decmike91/spectro/docs/images/android_4_traitement.png

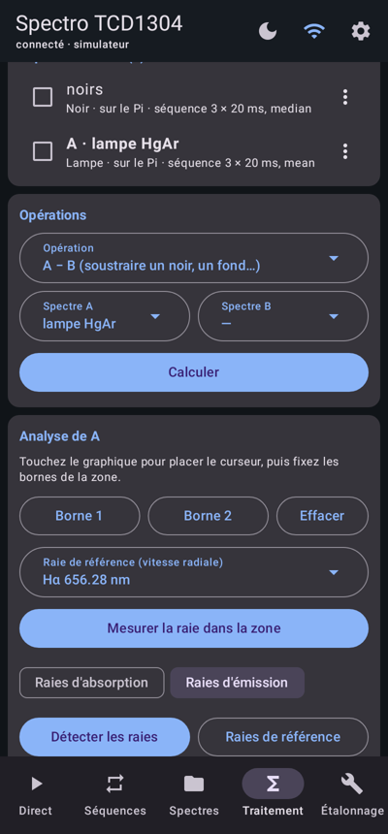
docs/images/android_4_traitement.png
