decmike91/spectro/docs/images/schema_electronique.png

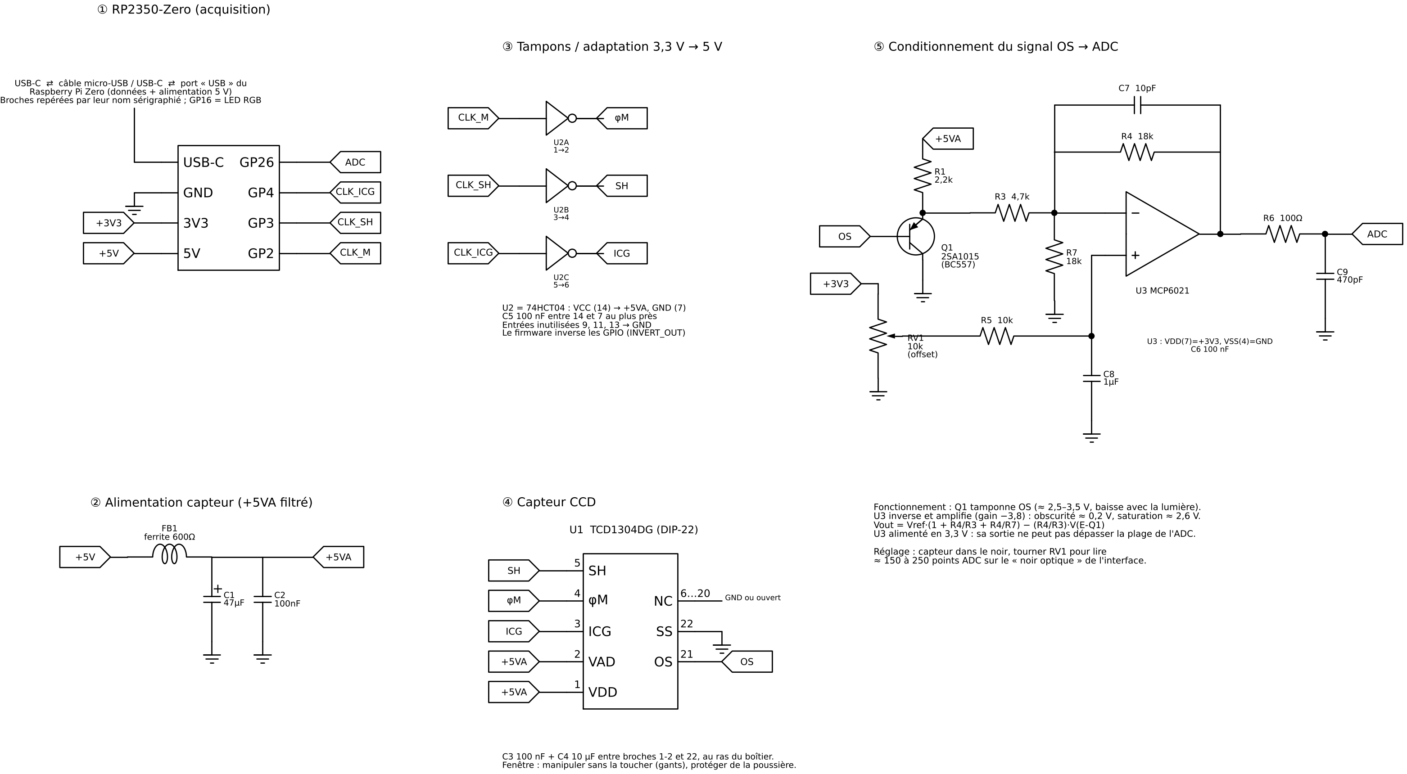
docs/images/schema_electronique.png
