decmike91/spectro/docs/images/v1_dessus.png

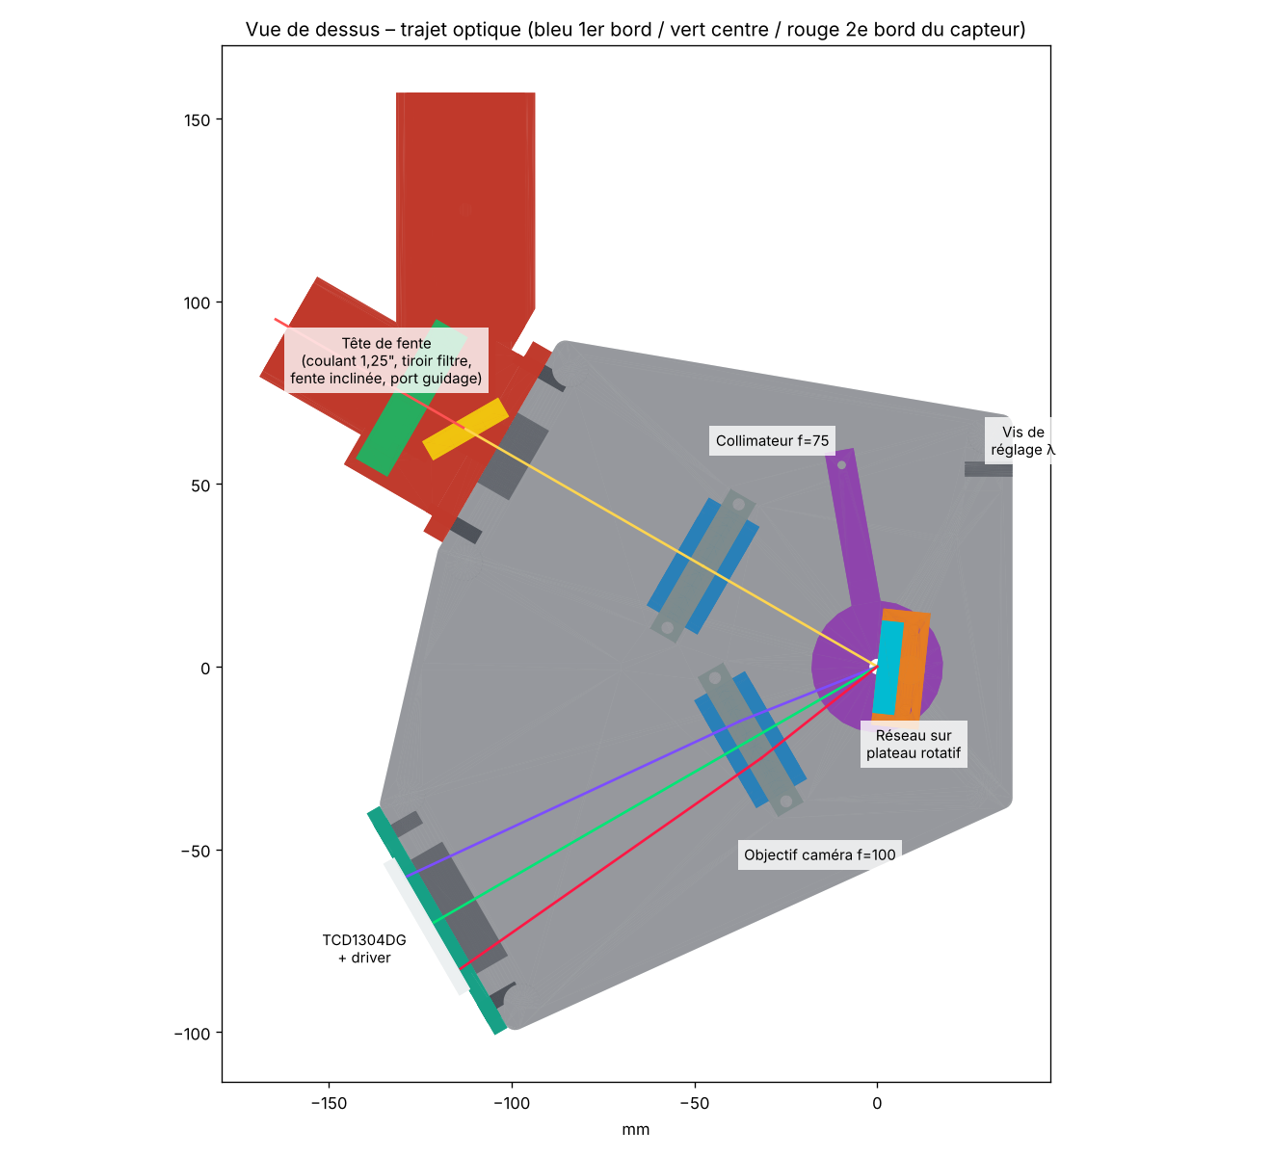
docs/images/v1_dessus.png
