decmike91/spectro/docs/images/v1_iso.png

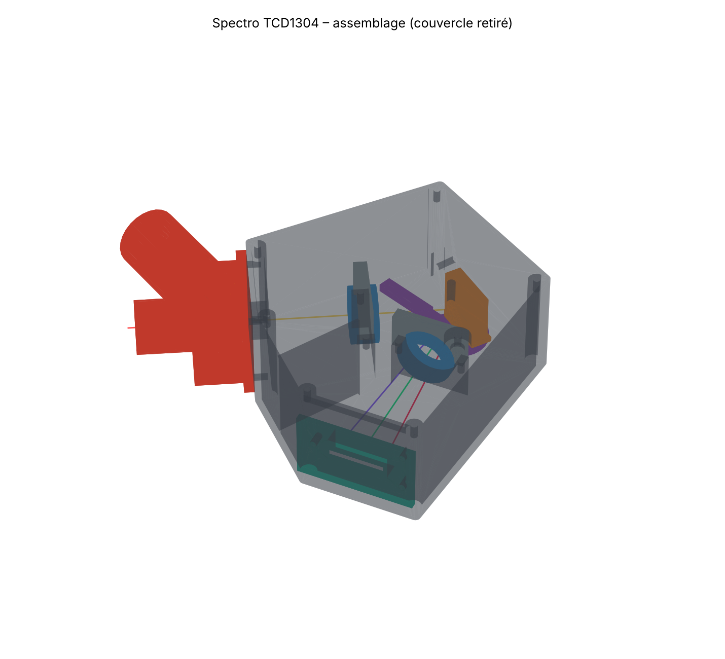
docs/images/v1_iso.png
