decmike91/spectro/docs/images/v2_iso.png

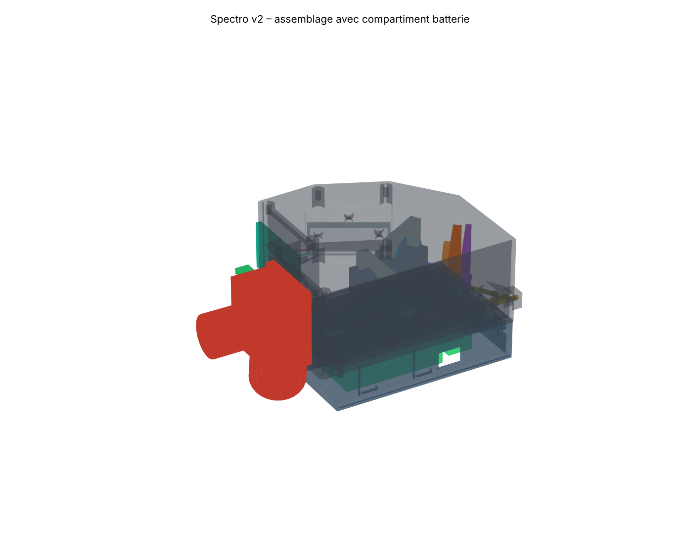
docs/images/v2_iso.png
