decmike91/spectro/docs/images/v2_monture_reseau.png

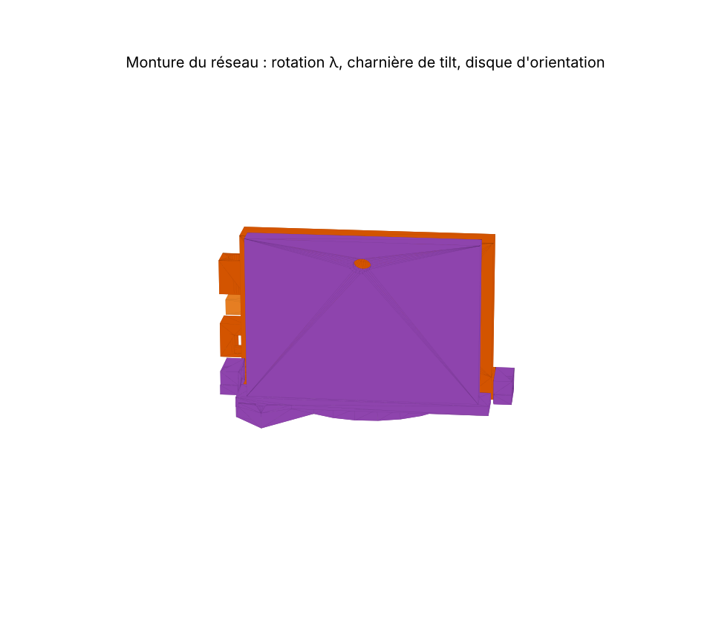
docs/images/v2_monture_reseau.png
