decmike91/spectro/mecanique/v2/export_v2/spectro_v2_assemblage.step

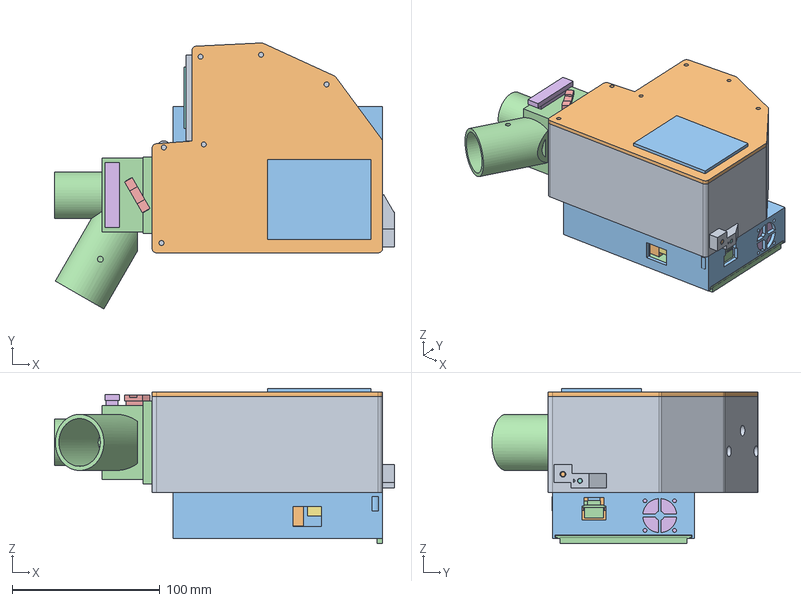
[picture p16: CAD file, 2026-11-10]
mecanique/v2/export_v2/spectro_v2_assemblage.step
230.0 x 180.0 x 104.9 mm
01_boitier
02_couvercle
03_trappe
04_tete_fente
05_cassette_fente
06_tiroir_filtre
07_chariot_coll
08_tube_coll
09_bride_coll
10_chariot_cam
11_tube_cam
12_bride_cam
13_plateau_equerre
14_cadre_tilt
15_disque_reseau
16_plaque_miroir
17_plaque_capteur
18_masque_capteur
23_compartiment_batterie
24_couvercle_batterie
25_bride_penglin
dummy_reseau
dummy_miroir
dummy_capteur
dummy_accus
dummy_vis_coll
dummy_vis_cam
dummy_vis_lambda
