decmike91/spectro/mecanique/v2/export_v2/23_compartiment_batterie.stl

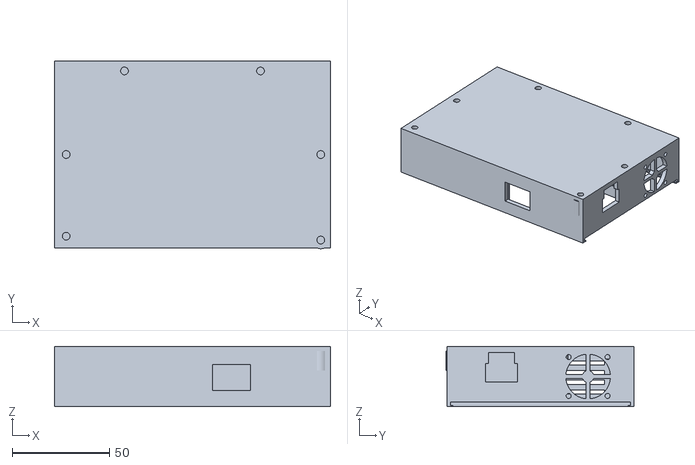
[picture p17: CAD file, 2026-11-10]
mecanique/v2/export_v2/23_compartiment_batterie.stl
142.0 x 96.5 x 31.0
