decmike91/spectro/mecanique/v2/export_v2/25_bride_penglin.stl

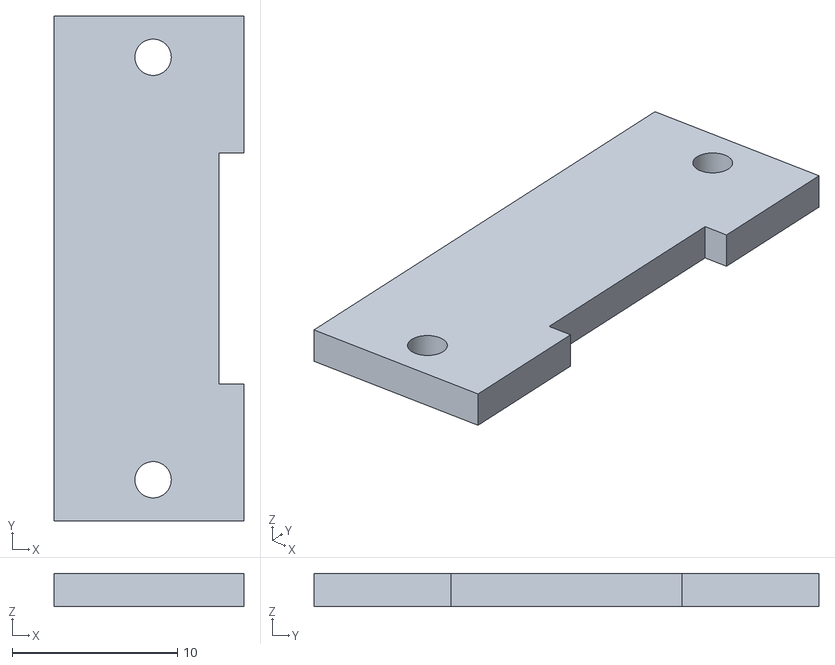
[picture p18: CAD file, 2026-11-10]
mecanique/v2/export_v2/25_bride_penglin.stl
11.5 x 30.6 x 2.00
