decmike91/spectro/mecanique/v2/export_v2/18_masque_capteur.stl

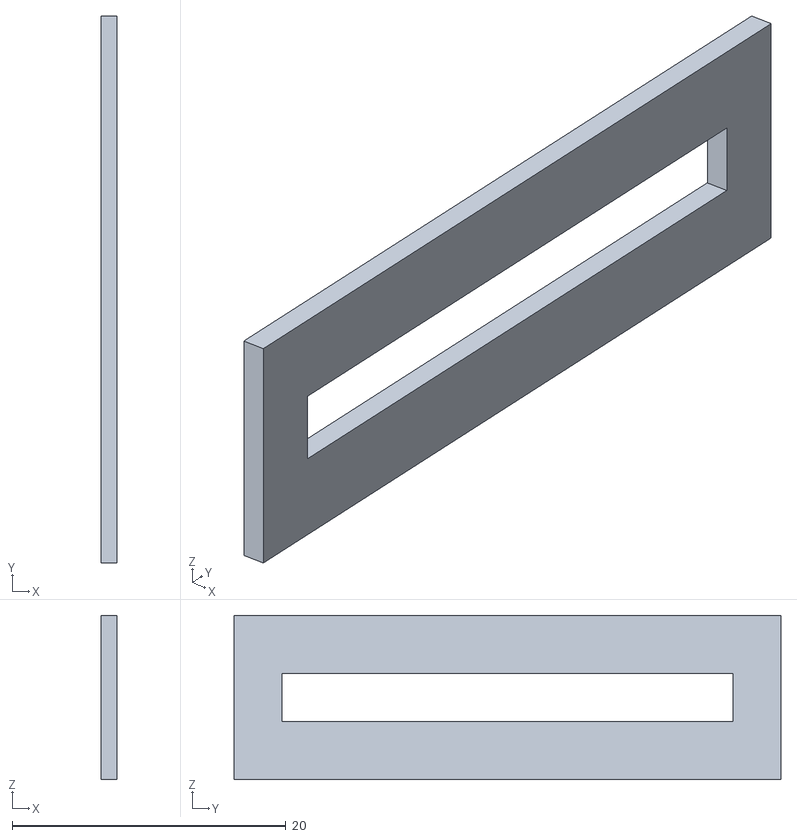
[picture p19: CAD file, 2026-11-09]
mecanique/v2/export_v2/18_masque_capteur.stl
1.20 x 40.0 x 12.0
