decmike91/spectro/mecanique/v2/export_v2/08_tube_coll.stl

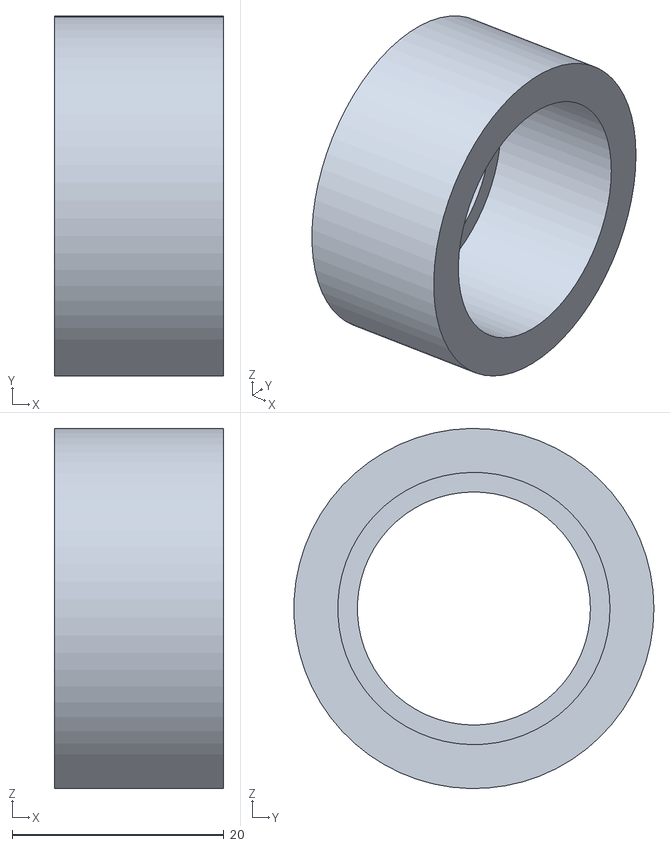
[picture p20: CAD file, 2026-11-09]
mecanique/v2/export_v2/08_tube_coll.stl
16.0 x 34.0 x 34.0
