decmike91/spectro/mecanique/v2/export_v2/21_bague_lentille.stl

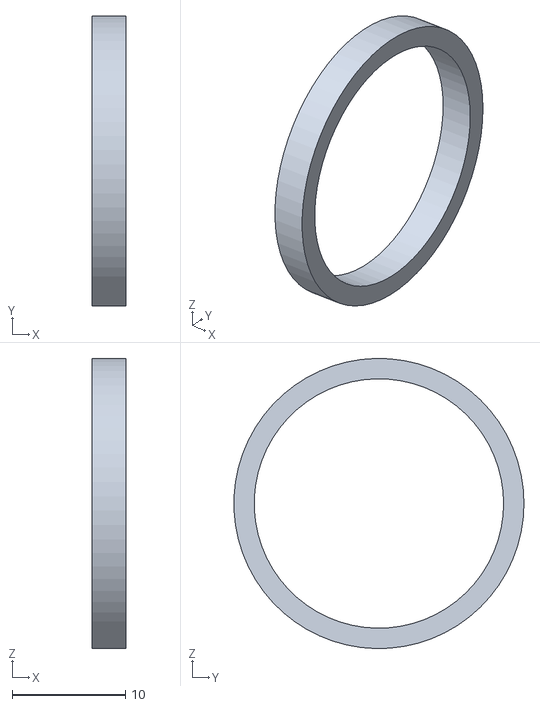
[picture p21: CAD file, 2026-11-09]
mecanique/v2/export_v2/21_bague_lentille.stl
3.00 x 25.6 x 25.6
