decmike91/spectro/mecanique/v2/export_v2/17_plaque_capteur.stl

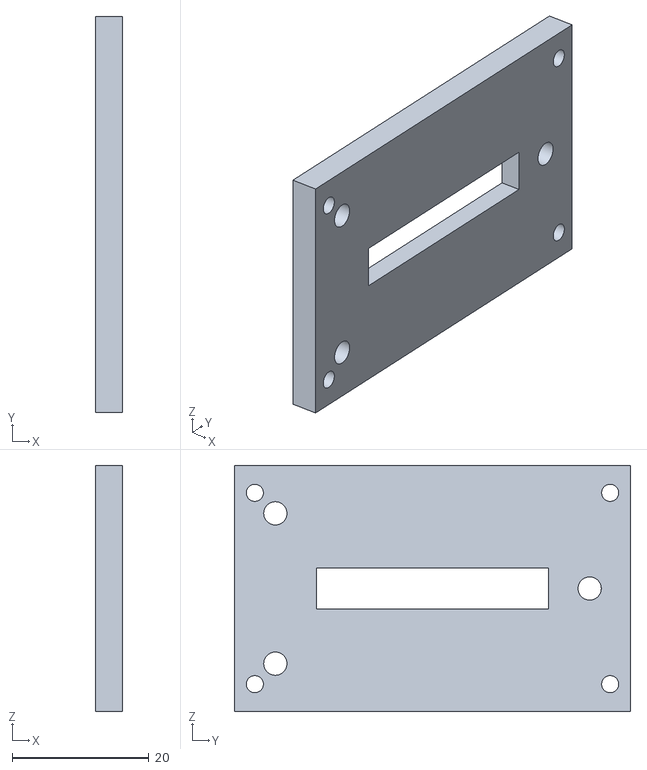
[picture p22: CAD file, 2026-11-09]
mecanique/v2/export_v2/17_plaque_capteur.stl
4.00 x 58.0 x 36.0
