decmike91/spectro/mecanique/v2/export_v2/04_tete_fente.stl

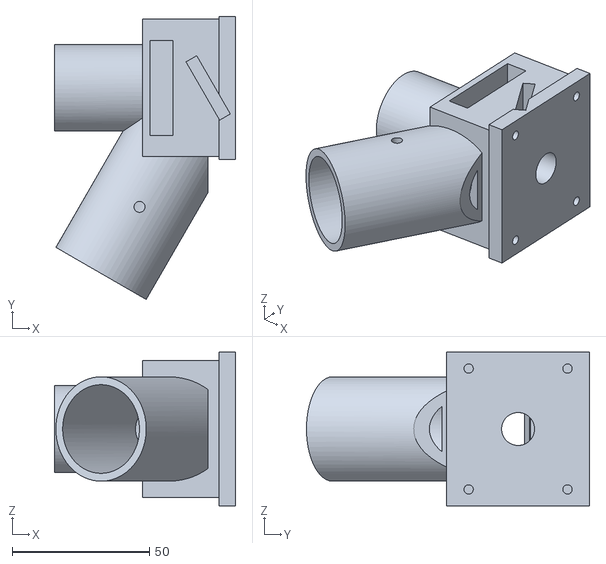
[picture p23: CAD file, 2026-11-09]
mecanique/v2/export_v2/04_tete_fente.stl
66.0 x 103.0 x 56.0
