decmike91/spectro/mecanique/v2/export_v2/14_cadre_tilt.stl

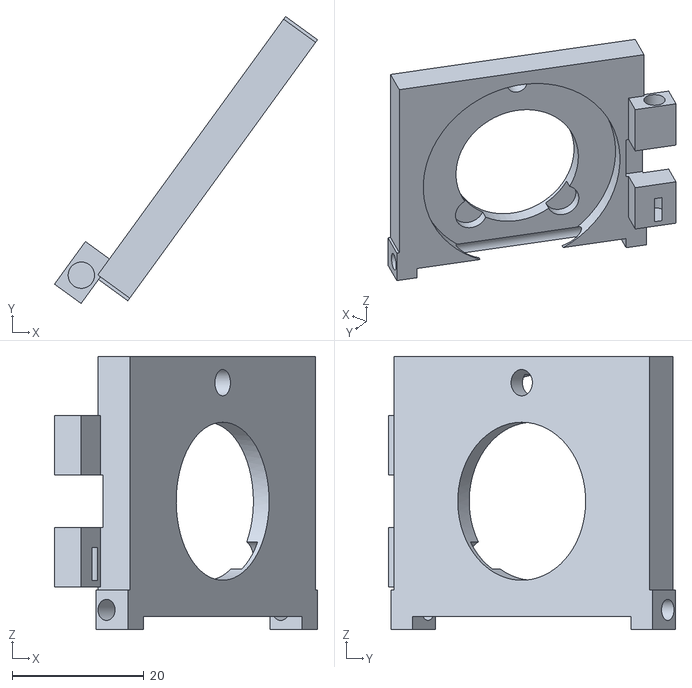
[picture p24: CAD file, 2026-11-09]
mecanique/v2/export_v2/14_cadre_tilt.stl
39.9 x 43.6 x 41.5
