decmike91/spectro/mecanique/v2/export_v2/19_capuchon_source.stl

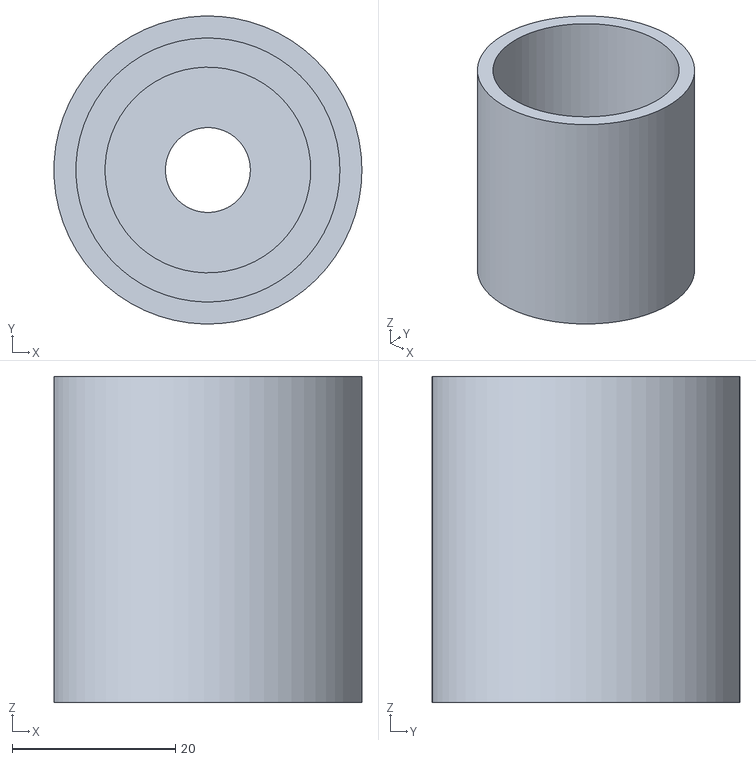
[picture p25: CAD file, 2026-11-09]
mecanique/v2/export_v2/19_capuchon_source.stl
37.7 x 37.7 x 40.0
