decmike91/spectro/mecanique/v2/export_v2/10_chariot_cam.stl

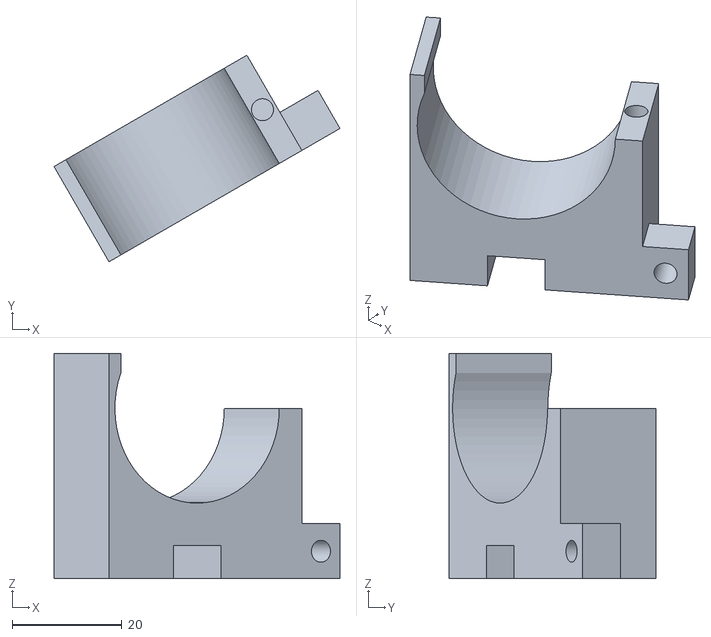
[picture p26: CAD file, 2026-11-09]
mecanique/v2/export_v2/10_chariot_cam.stl
52.0 x 37.6 x 41.0
