decmike91/spectro/mecanique/v2/export_v2/20_porte_relais.stl

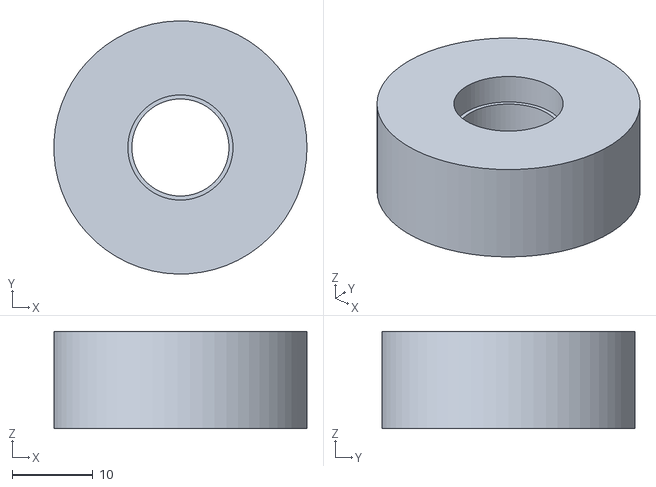
[picture p27: CAD file, 2026-11-09]
mecanique/v2/export_v2/20_porte_relais.stl
31.3 x 31.3 x 12.0
