decmike91/spectro/mecanique/v2/export_v2/06_tiroir_filtre.stl

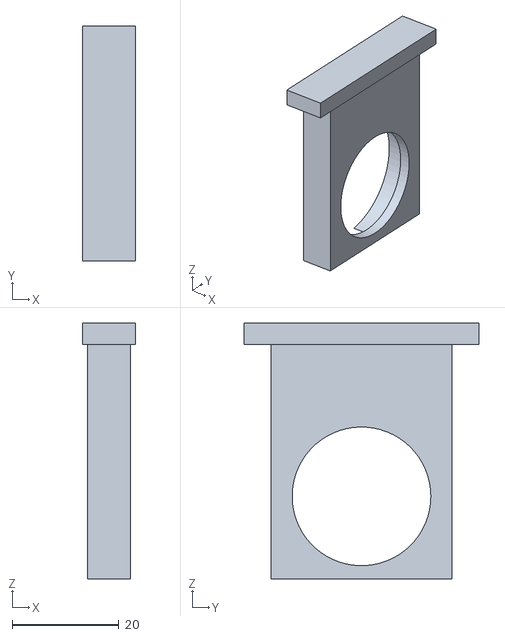
[picture p28: CAD file, 2026-11-09]
mecanique/v2/export_v2/06_tiroir_filtre.stl
10.0 x 44.0 x 48.0
