decmike91/spectro/mecanique/v2/export_v2/15_disque_reseau.stl

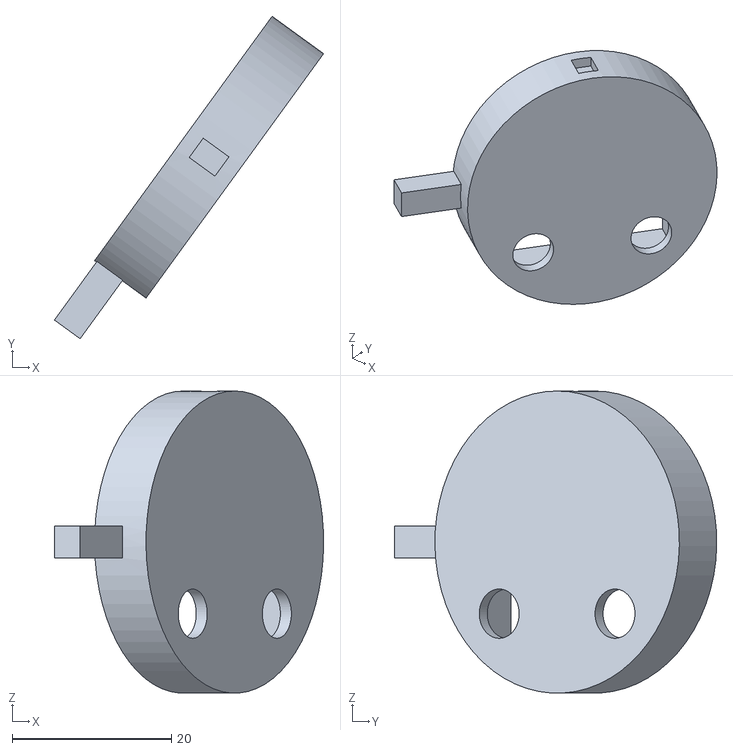
[picture p29: CAD file, 2026-11-09]
mecanique/v2/export_v2/15_disque_reseau.stl
33.9 x 40.5 x 38.0
