decmike91/spectro/mecanique/v2/export_v2/12_bride_cam.stl

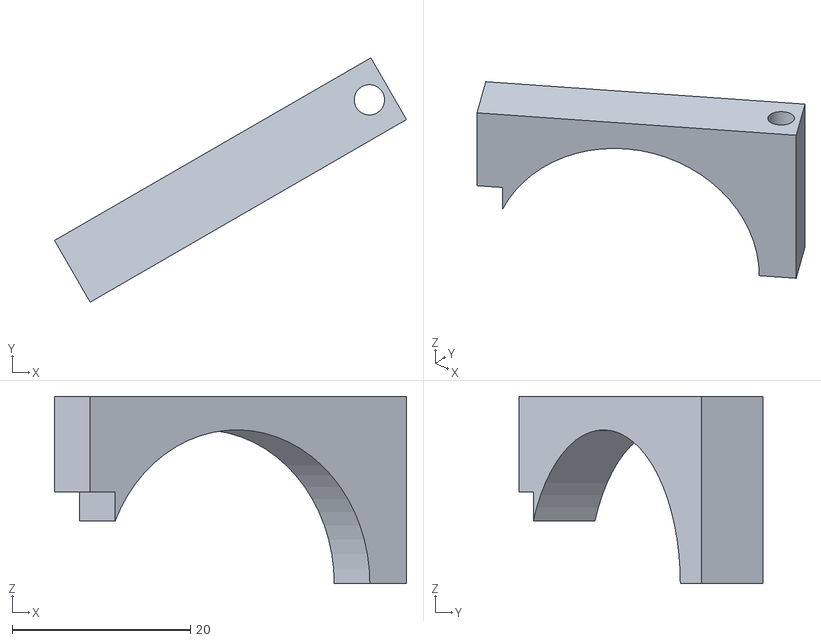
[picture p30: CAD file, 2026-11-09]
mecanique/v2/export_v2/12_bride_cam.stl
39.5 x 27.4 x 21.0
