decmike91/spectro/mecanique/v2/export_v2/16_plaque_miroir.stl

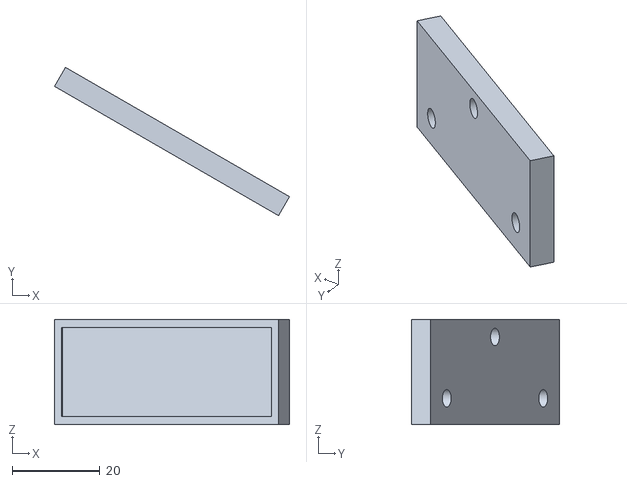
[picture p31: CAD file, 2026-11-09]
mecanique/v2/export_v2/16_plaque_miroir.stl
53.6 x 33.8 x 24.0
