decmike91/spectro/mecanique/v2/export_v2/24_couvercle_batterie.stl

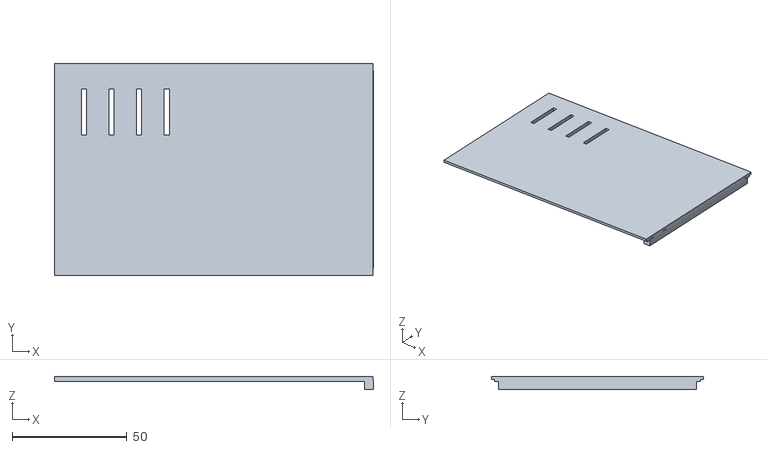
[picture p32: CAD file, 2026-11-09]
mecanique/v2/export_v2/24_couvercle_batterie.stl
138.9 x 92.1 x 5.55
