decmike91/spectro/mecanique/v2/export_v2/05_cassette_fente.stl

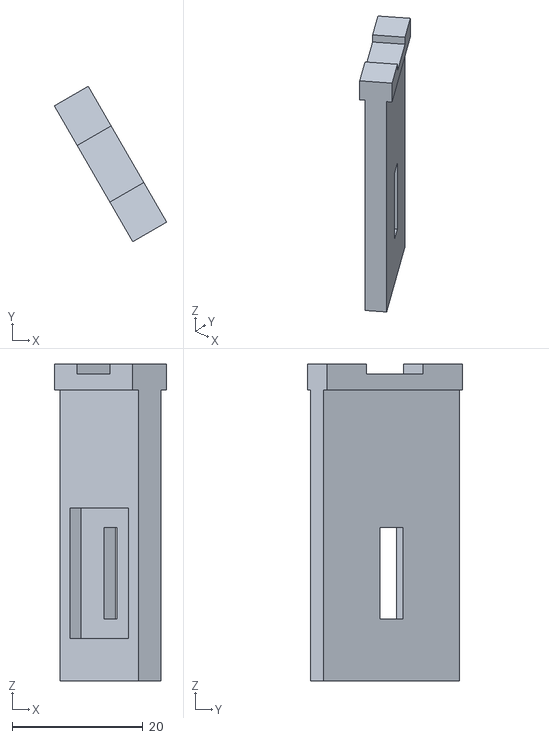
[picture p33: CAD file, 2026-11-09]
mecanique/v2/export_v2/05_cassette_fente.stl
17.2 x 23.8 x 48.5
