decmike91/spectro/mecanique/v2/export_v2/22_bouton_x3.stl

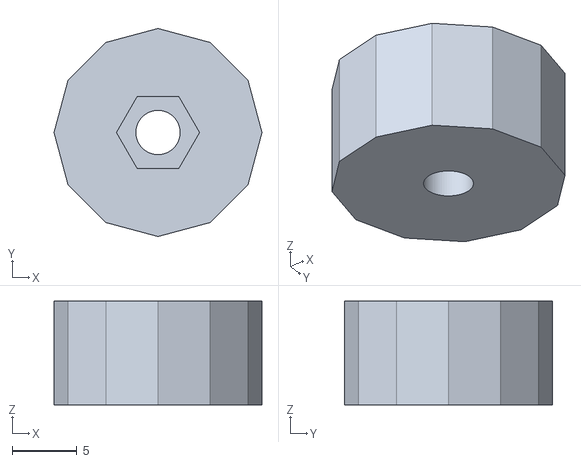
[picture p34: CAD file, 2026-11-09]
mecanique/v2/export_v2/22_bouton_x3.stl
16.0 x 16.0 x 8.00
