decmike91/spectro/mecanique/v2/export_v2/09_bride_coll.stl

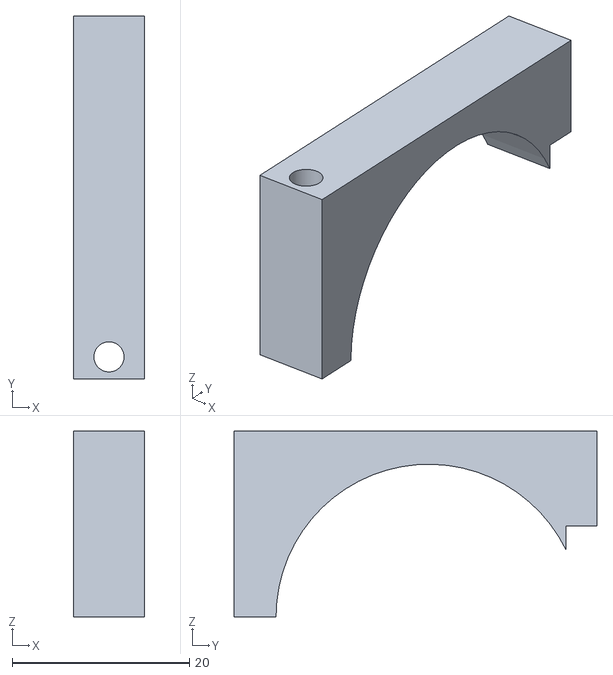
[picture p35: CAD file, 2026-11-09]
mecanique/v2/export_v2/09_bride_coll.stl
8.00 x 41.0 x 21.0
