decmike91/spectro/mecanique/v2/export_v2/01_boitier.stl

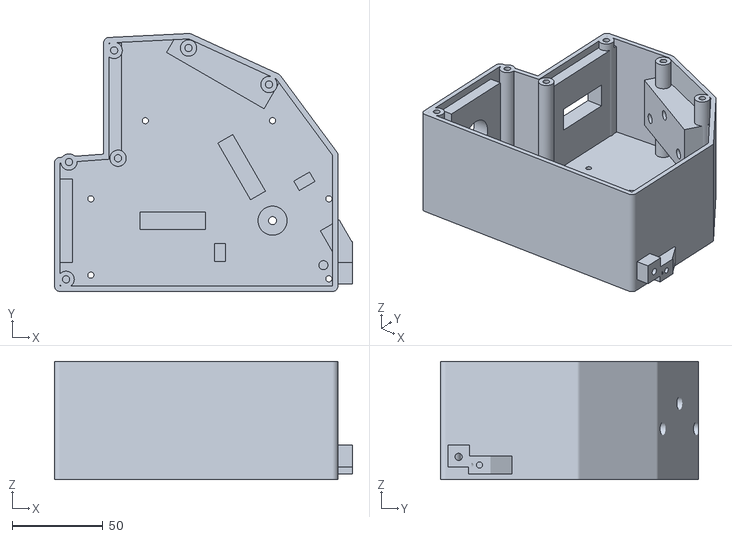
[picture p36: CAD file, 2026-11-09]
mecanique/v2/export_v2/01_boitier.stl
164.0 x 142.0 x 65.0
