decmike91/spectro/mecanique/v2/export_v2/03_trappe.stl

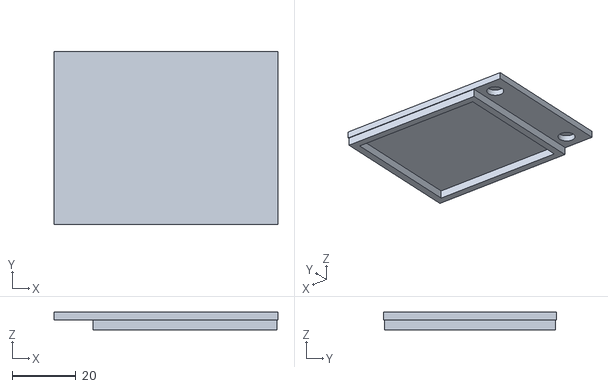
[picture p37: CAD file, 2026-11-09]
mecanique/v2/export_v2/03_trappe.stl
70.0 x 54.0 x 5.50
