decmike91/spectro/mecanique/v2/export_v2/11_tube_cam.stl

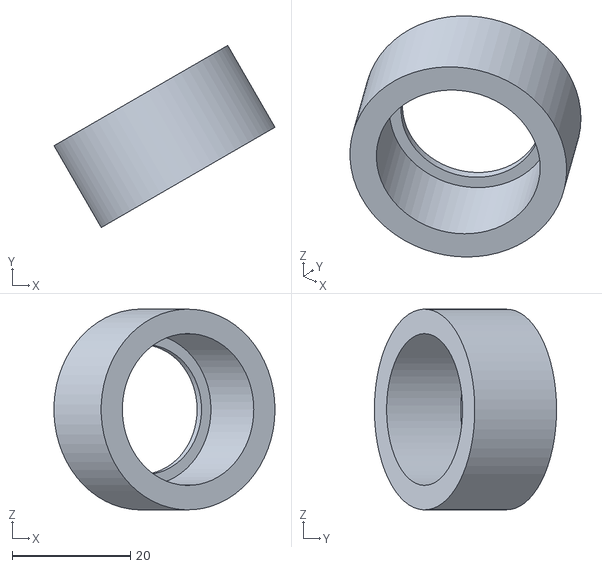
[picture p38: CAD file, 2026-11-09]
mecanique/v2/export_v2/11_tube_cam.stl
37.4 x 30.8 x 34.0
