decmike91/spectro/mecanique/v2/export_v2/13_plateau_equerre.stl

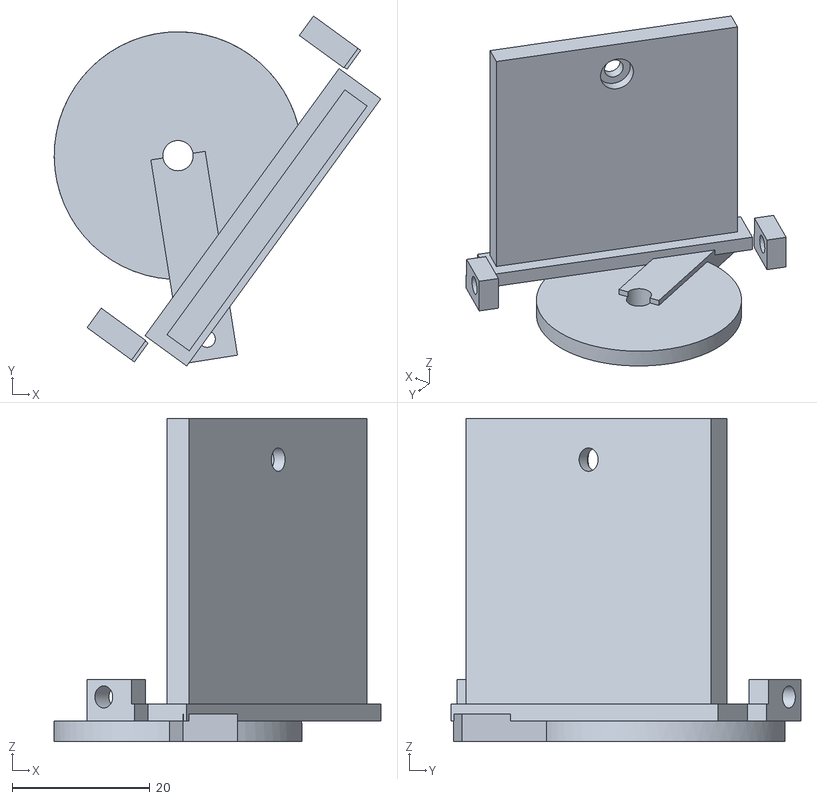
[picture p39: CAD file, 2026-11-09]
mecanique/v2/export_v2/13_plateau_equerre.stl
47.5 x 50.9 x 47.0
