decmike91/spectro/mecanique/v2/export_v2/07_chariot_coll.stl

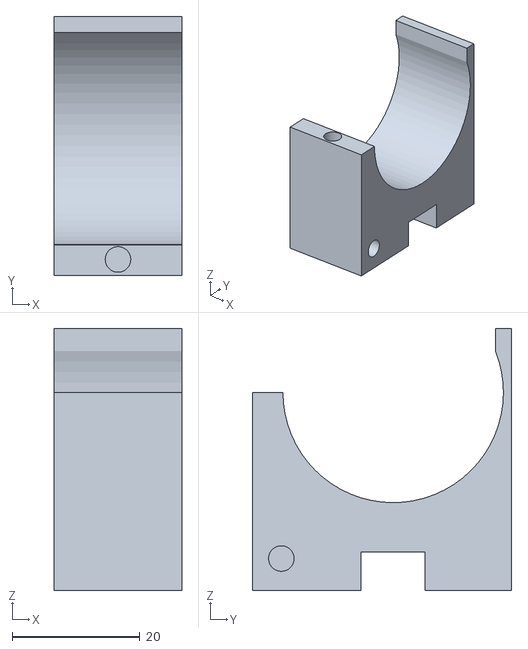
[picture p40: CAD file, 2026-11-09]
mecanique/v2/export_v2/07_chariot_coll.stl
20.0 x 40.5 x 41.0
