decmike91/spectro/mecanique/v2/export_v2/02_couvercle.stl

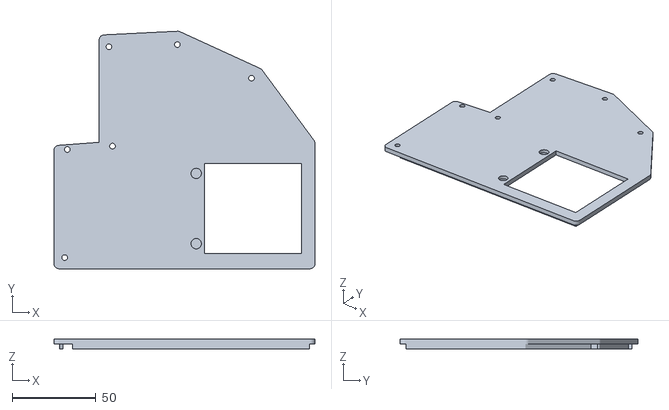
[picture p41: CAD file, 2026-11-09]
mecanique/v2/export_v2/02_couvercle.stl
156.0 x 142.0 x 6.00
