decmike91/spectro/(list of files, cad)

Other CAD files:
mecanique/v1/export/01_boitier.stl
mecanique/v1/export/02_couvercle.stl
mecanique/v1/export/03_trappe_reseau.stl
mecanique/v1/export/04_tete_fente.stl
mecanique/v1/export/05_cassette_fente.stl
mecanique/v1/export/06_tiroir_filtre.stl
mecanique/v1/export/07_tube_collimateur.stl
mecanique/v1/export/08_tube_camera.stl
mecanique/v1/export/09_bride_coll.stl
mecanique/v1/export/10_bride_cam.stl
mecanique/v1/export/11_plateau_reseau.stl
mecanique/v1/export/12_cassette_reseau.stl
mecanique/v1/export/13_plaque_capteur.stl
mecanique/v1/export/14_masque_capteur.stl
mecanique/v1/export/dummy_capteur.stl
mecanique/v1/export/dummy_reseau.stl
mecanique/v1/export/spectro_assemblage.step
