decmike91/spectro/(commit log)

2026-11-09 Spectroscope TCD1304DG : conception, mécanique, optique et logiciel
    - docs : dossier de conception (PDF) et images
    - optique : bilan optique par réseau et par fente
    - mecanique/v2 : modèle CadQuery paramétrique replié par miroir,
    réglages de mise au point et du réseau, compartiment électronique
    ventilé ; 24 STL + STEP ; scripts de vérification
    - mecanique/v1 : première version pour comparaison
    - logiciel : firmware MicroPython du Pico, pilote Python, interface
    PyQt5/pyqtgraph et schéma électronique (repris de la conception
    « Capteur TCD1304DG et Raspberry Pi »)
    Claude-Session: https://claude.ai/code/session_01LJb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
    [01_boitier.stl, 02_couvercle.stl, 03_trappe.stl, 03_trappe_reseau.stl, 04_tete_fente.stl, 05_cassette_fente.stl, 06_tiroir_filtre.stl, 07_chariot_coll.stl]
2026-11-09 Appli Android et serveur du Pi Zero
    - logiciel/serveur : serveur aiohttp (API HTTP + WebSocket) pour le Pi Zero :
    direct, acquisitions, séquences (moyenne/médiane/somme, noir, arrêt),
    bibliothèque de spectres, export CSV/FITS, étalonnage, ventilateur GPIO ;
    service systemd et annonce avahi
    - android : appli Kotlin/Compose (direct, séquences, bibliothèque,
    traitements, analyse des raies, étalonnage, mode nuit) et tests
    unitaires du moteur de calcul
    - workflow GitHub Actions : tests, compilation et publication de l'APK
    Claude-Session: https://claude.ai/code/session_01LJbvFpK3rS26eGNp4qMTuE
2026-11-09 Test d'intégration de l'appli avec le serveur en simulateur
    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
2026-11-09 Test d'intégration : méthode JUnit sans valeur de retour
    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
2026-11-09 Journal détaillé des tests
    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
2026-11-09 Captures d'écran automatiques des écrans (Robolectric) ; découverte réseau tolérante
    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
2026-11-09 Captures : attendre l'arrêt du direct avant la capture
    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
2026-11-09 Captures : rendu direct de la vue (sans captureToImage), traces d'erreur complètes
    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
2026-11-09 Diagnostic des captures d'écran ; journal des requêtes du serveur (--verbose)
    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
2026-11-09 Captures : faire tourner la boucle principale de Robolectric pendant les attentes
    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
2026-11-09 Étalonnage : raies saturées (centre du plateau, avertissement) ; vérification de l'étalonnage dans les captures
    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
2026-11-09 Messages : le plus récent remplace le précédent ; captures : attendre la fin des messages avant les clics
    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
2026-11-09 Captures d'écran de l'appli dans le mode d'emploi
    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
2026-11-10 Publier l'APK dans une release aussi depuis la branche appli-android ; actions à jour (Node 24)
    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
2026-11-10 Électronique réelle : RP2350-Zero, 2×18650 + BMS + module PENGLIN
    - firmware : détection RP2040/RP2350 (adresses ADC/IO_BANK0, OUTOVER, DREQ ADC),
    LED RGB WS2812 de la RP2350-Zero
    - compartiment : support 2×18650 tenu par sangles, berceau + bride (pièce 25) du
    module PENGLIN, fenêtre USB-C (charge) + USB-A (sortie 5 V anti-buée), carte
    d'interface 50×30 portant la RP2350-Zero, interrupteur et BMS déplacés
    - check_compartiment.py : aucune collision entre composants, parois, couvercle
    - schéma, nomenclature, docs/alimentation.md (câblage et montage)
    Claude-Session: https://claude.ai/code/session_01LJbvFpK3rS26eGNp4qMTu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
    [23_compartiment_batterie.stl, 25_bride_penglin.stl, spectro_v2_assemblage.step]
2026-11-10 Alimentation : BMS 1S 6 A (DW01 + 8205) au lieu de 3 A
    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
